TimTini/snaplock-storage-box/exports/default/preview.png

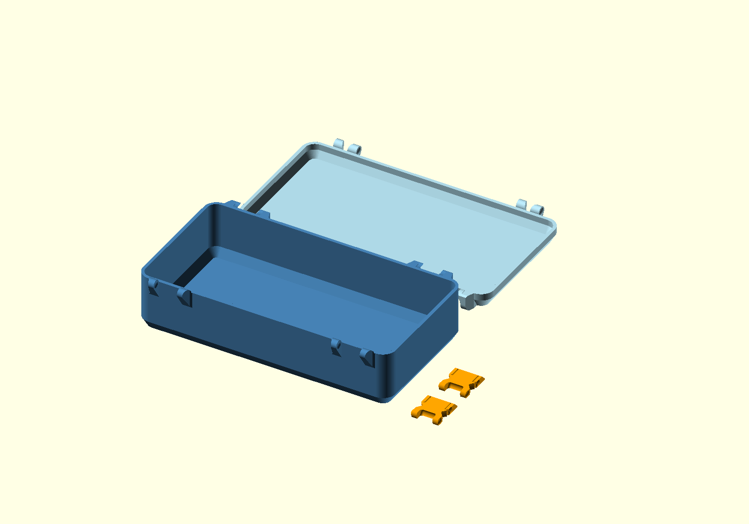
exports/default/preview.png
