TimTini/snaplock-storage-box/exports/default/sections.png

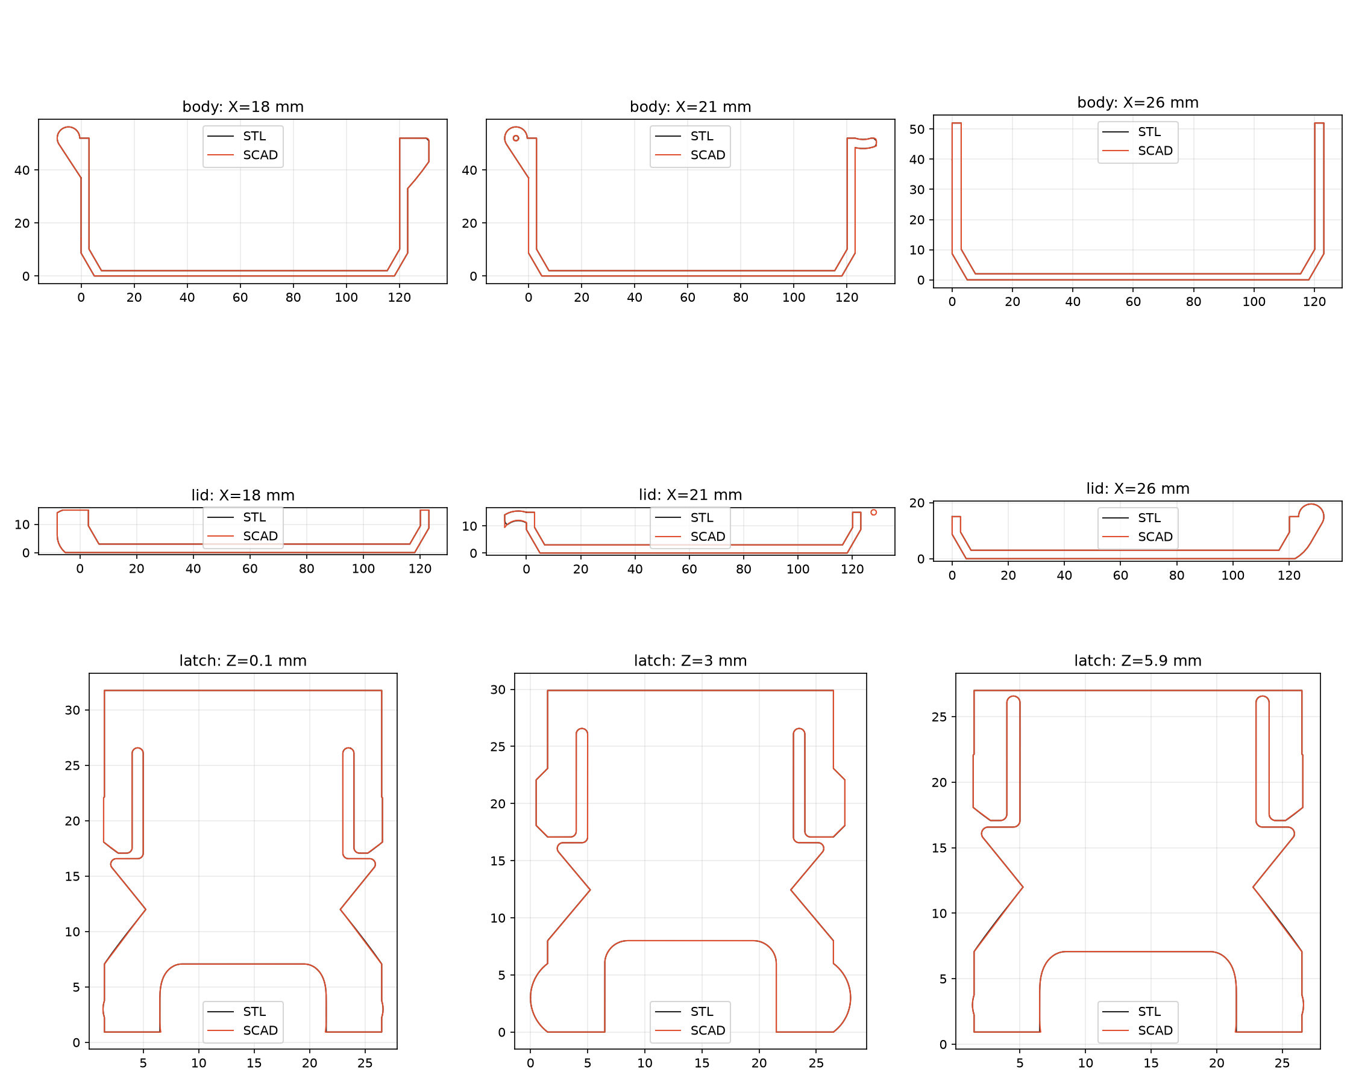
exports/default/sections.png
