TimTini/snaplock-storage-box/samples/fusion-minimum/native-preview.png

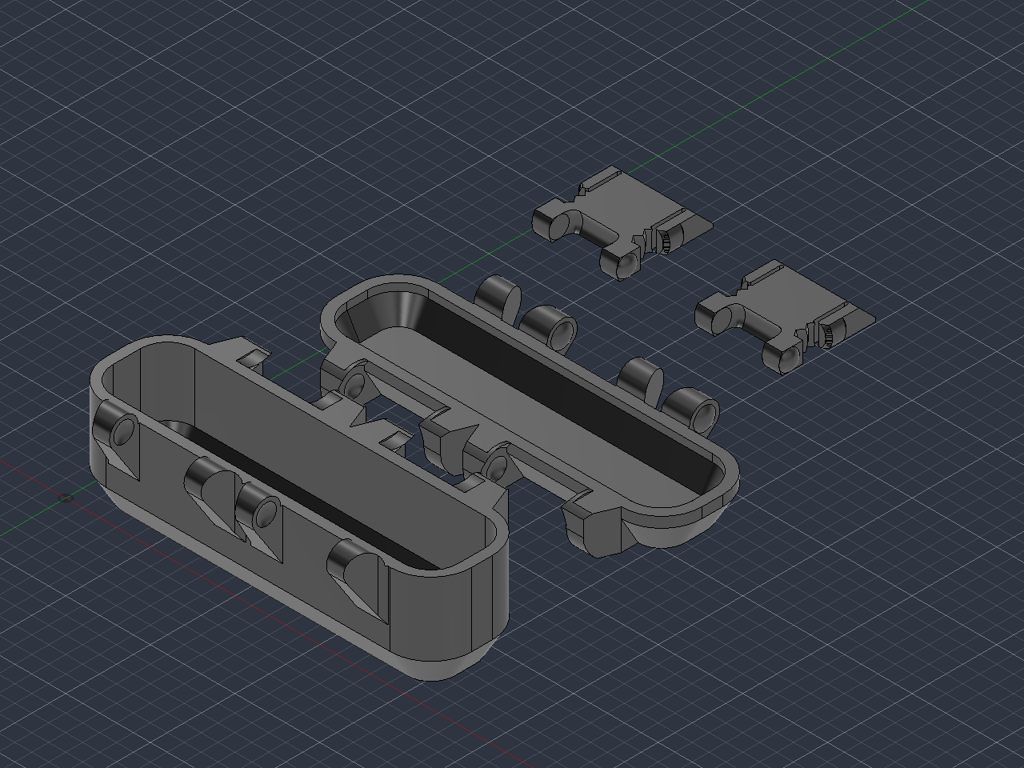
samples/fusion-minimum/native-preview.png
