TimTini/snaplock-storage-box/docs/validation/scad-parametric-assembly.csv

name | length | width | body_height | lid_height | status | max_latch_body_mm3 | max_latch_lid_mm3 | body_lid_mm3 | rear_contact_mm3 | other_contact_mm3 | within_print_envelope
grid-107.9-30.1-30.2 | 107.9 | 30.1 | 30.2 | 15 | closed_clear | 2.873825072052514e-15 | 0.0 | 9.01508005564351e-14 | 0.0 | 9.01508005564351e-14 | True
grid-107.9-30.1-50 | 107.9 | 30.1 | 50 | 15 | closed_clear | 1.1315088418159562e-13 | 8.298483428204051e-15 | 2.1815974965860418e-13 | 0.0 | 2.1815974965860418e-13 | True
grid-107.9-30.1-100 | 107.9 | 30.1 | 100 | 15 | closed_clear | 0.0 | 1.0161142760534148e-14 | 4.170900938211702e-13 | 0.0 | 4.170900938211702e-13 | True
grid-107.9-60-30.2 | 107.9 | 60 | 30.2 | 15 | closed_clear | 0.0 | 7.328686268959217e-14 | 2.8765719838361296e-13 | 0.0 | 2.8765719838361296e-13 | True
grid-107.9-60-50 | 107.9 | 60 | 50 | 15 | closed_clear | 4.4653139427535775e-13 | 6.915301664633944e-14 | 0.0 | 0.0 | 0.0 | True
grid-107.9-60-100 | 107.9 | 60 | 100 | 15 | closed_clear | 0.0 | 5.3927348697691e-14 | 0.0 | 0.0 | 0.0 | True
grid-107.9-120-30.2 | 107.9 | 120 | 30.2 | 15 | closed_clear | 0.0 | 1.4657372537918434e-13 | 0.0 | 0.0 | 0.0 | True
grid-107.9-120-50 | 107.9 | 120 | 50 | 15 | closed_clear | 7.615939257989345e-14 | 1.3830603329267888e-13 | 0.0 | 0.0 | 0.0 | True
grid-107.9-120-100 | 107.9 | 120 | 100 | 15 | closed_clear | 1.6758593967046111e-13 | 1.07854697395382e-13 | 0.0 | 0.0 | 0.0 | True
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
below-length | 107.8 | 60 | 50 | 15 | rejected_source_bounds | 0 | 0
below-width | 150 | 30 | 50 | 15 | rejected_source_bounds | 0 | 0
below-body-height | 150 | 60 | 30.1 | 15 | rejected_source_bounds | 0 | 0
below-lid-height | 150 | 60 | 50 | 11.6 | rejected_source_bounds | 0 | 0
