TimTini/snaplock-storage-box/exports/default/body.stl

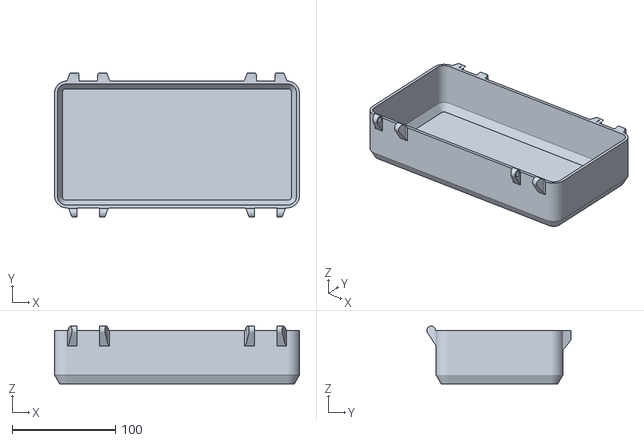
[picture p13: CAD file, 2026-10-13]
exports/default/body.stl
237.9 x 140.1 x 56.2
