TimTini/snaplock-storage-box/samples/fusion-minimum/lid.stl

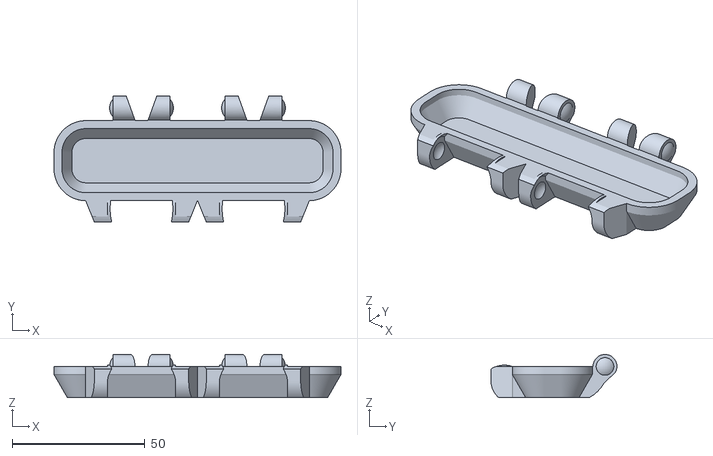
[picture p14: CAD file, 2026-10-14]
samples/fusion-minimum/lid.stl
107.9 x 47.3 x 16.2
