TimTini/snaplock-storage-box/exports/default/layout.stl

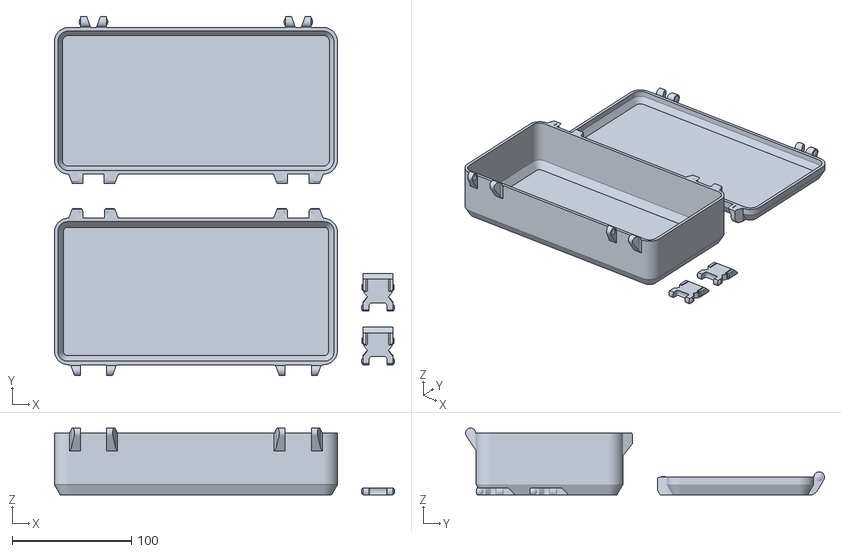
[picture p15: CAD file, 2026-10-13]
exports/default/layout.stl
285.8 x 301.5 x 56.2
