TimTini/snaplock-storage-box/samples/fusion-minimum/latch-2.stl

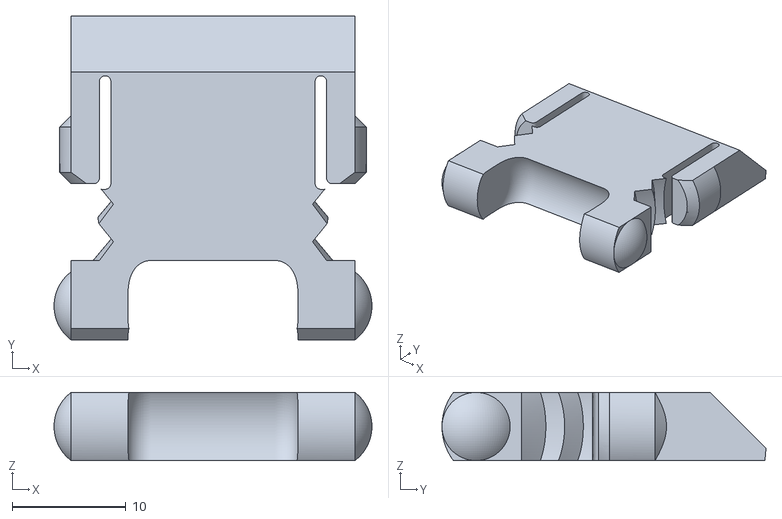
[picture p16: CAD file, 2026-10-14]
samples/fusion-minimum/latch-2.stl
28.0 x 28.5 x 6.00
