TimTini/snaplock-storage-box/exports/default/latch.stl

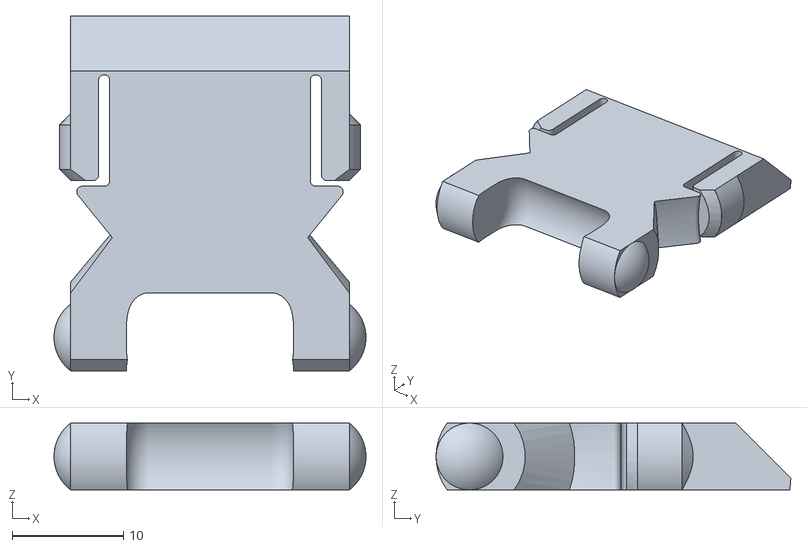
[picture p17: CAD file, 2026-10-13]
exports/default/latch.stl
28.0 x 31.8 x 6.00
