TimTini/snaplock-storage-box/samples/fusion-minimum/body.stl

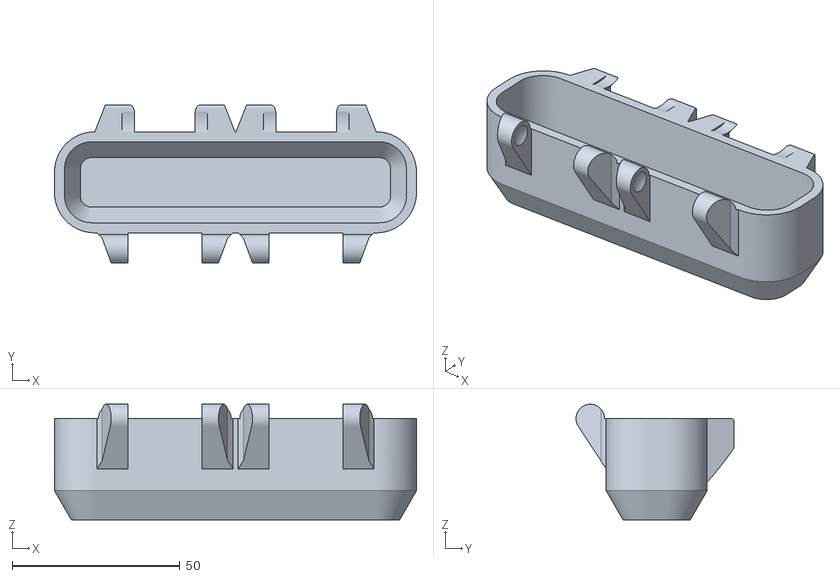
[picture p18: CAD file, 2026-10-14]
samples/fusion-minimum/body.stl
107.9 x 47.1 x 34.4
