TimTini/snaplock-storage-box/exports/default/lid.stl

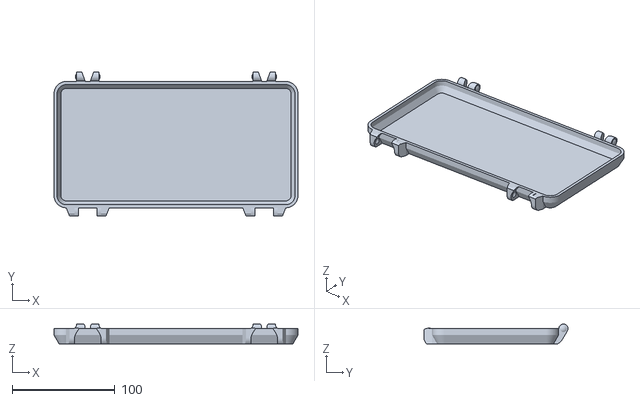
[picture p19: CAD file, 2026-10-13]
exports/default/lid.stl
237.9 x 140.4 x 19.5
