TimTini/snaplock-storage-box/samples/fusion-minimum/layout.stl

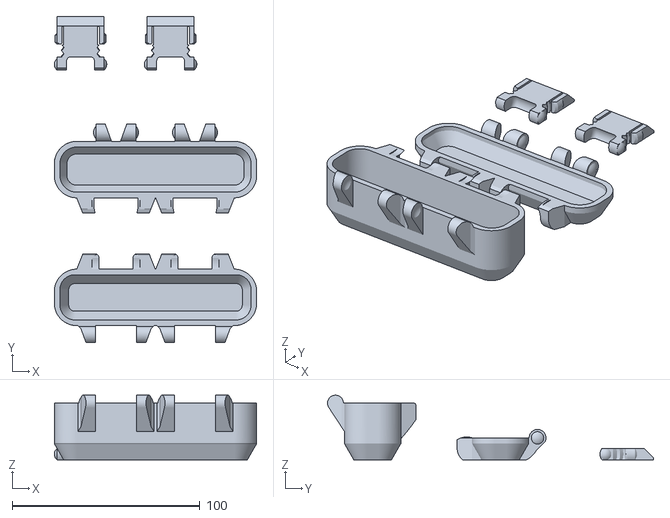
[picture p20: CAD file, 2026-10-14]
samples/fusion-minimum/layout.stl
107.9 x 173.7 x 34.4
