TimTini/snaplock-storage-box/samples/reinforced-240x220-enhanced/layout.stl

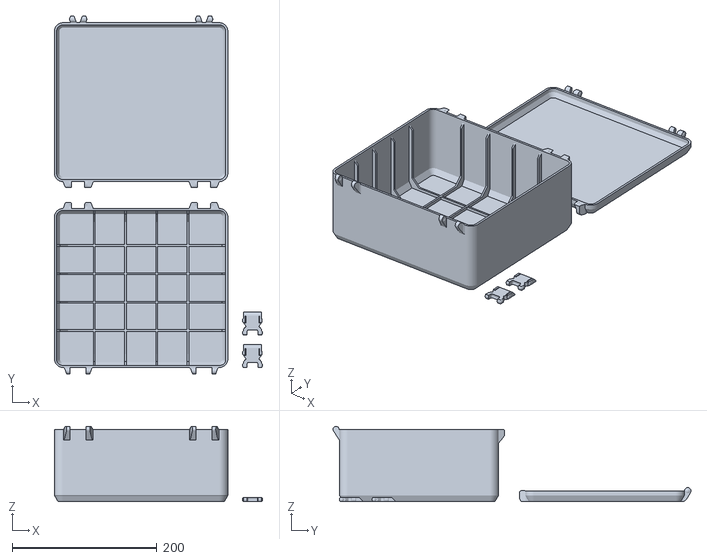
[picture p21: CAD file, 2026-10-13, an earlier design]
samples/reinforced-240x220-enhanced/layout.stl
288.0 x 495.2 x 104.2
