TimTini/snaplock-storage-box/samples/reinforced-240x220/lid.stl

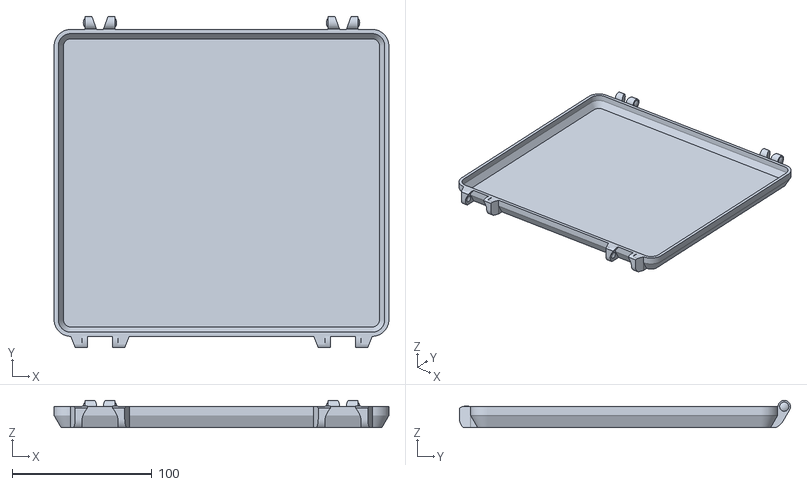
[picture p22: CAD file, 2026-10-13, an earlier design]
samples/reinforced-240x220/lid.stl
240.0 x 237.2 x 19.5
