TimTini/snaplock-storage-box/samples/minimum-lid15/lid.stl

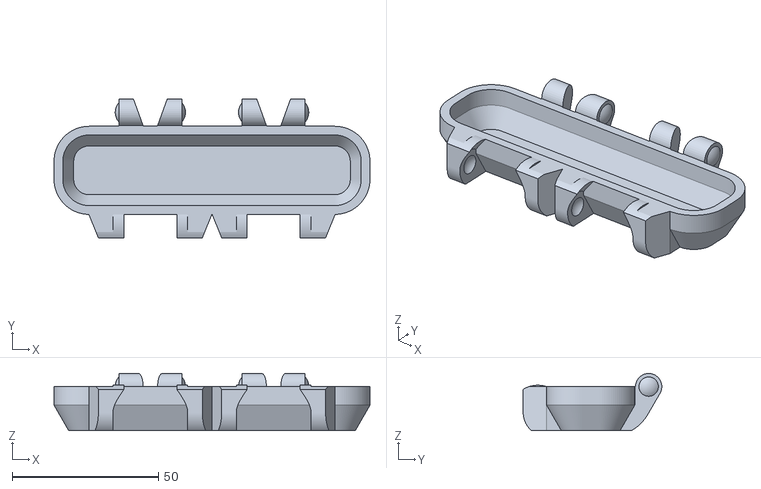
[picture p23: CAD file, 2026-10-13, an earlier design]
samples/minimum-lid15/lid.stl
107.9 x 47.3 x 19.5
