TimTini/snaplock-storage-box/samples/reinforced-240x220-enhanced/body.stl

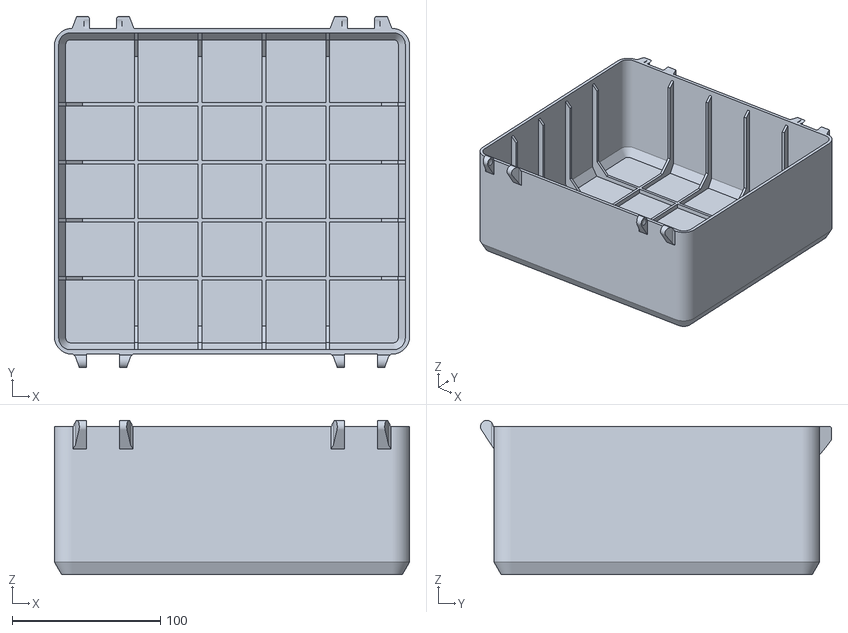
[picture p24: CAD file, 2026-10-13, an earlier design]
samples/reinforced-240x220-enhanced/body.stl
240.0 x 237.0 x 104.2
