TimTini/snaplock-storage-box/(list of files, cad)

Other CAD files:
samples/fusion-minimum/latch.stl
samples/minimum/latch.stl
samples/minimum/body.stl
samples/minimum/layout.stl
samples/minimum/lid.stl
samples/reinforced-240x220/body.stl
samples/reinforced-240x220/layout.stl
