TimTini/snaplock-storage-box/docs/validation/latch-size-matrix.csv

name | length | width | body_height | lid_height | status | max_latch_body_mm3 | max_latch_lid_mm3 | body_lid_mm3 | rear_contact_mm3 | other_contact_mm3
grid-107.9-30.1-30.2 | 107.9 | 30.1 | 30.2 | 15 | latch_clear | 0.00017263466264275383 | 2.2811613709095013e-16 | 6.2747627825592005 | 5.883868235745944 | 0.3908945468132563
grid-107.9-30.1-50 | 107.9 | 30.1 | 50 | 15 | latch_clear | 0.00017263465768553577 | 3.7669520280836366e-15 | 6.274093573222181 | 5.883877919299352 | 0.3902156539228292
grid-107.9-30.1-100 | 107.9 | 30.1 | 100 | 15 | latch_clear | 0.00017263465819112683 | 3.272078788474353e-14 | 6.274047329901294 | 5.8838316759782625 | 0.3902156539230317
grid-107.9-60-30.2 | 107.9 | 60 | 30.2 | 15 | latch_clear | 0.0 | 2.813721478034381e-15 | 6.274898882045667 | 5.883867463844314 | 0.39103141820135345
grid-107.9-60-50 | 107.9 | 60 | 50 | 15 | latch_clear | 8.511398442031823e-14 | 1.9761969838327786e-14 | 6.2740928013306645 | 5.883877147408514 | 0.39021565392215063
grid-107.9-60-100 | 107.9 | 60 | 100 | 15 | latch_clear | 0.0 | 6.364700433358905e-14 | 6.274046558009196 | 5.883830904087424 | 0.39021565392177227
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
