TimTini/snaplock-storage-box/docs/validation/scad-parametric-summary.png

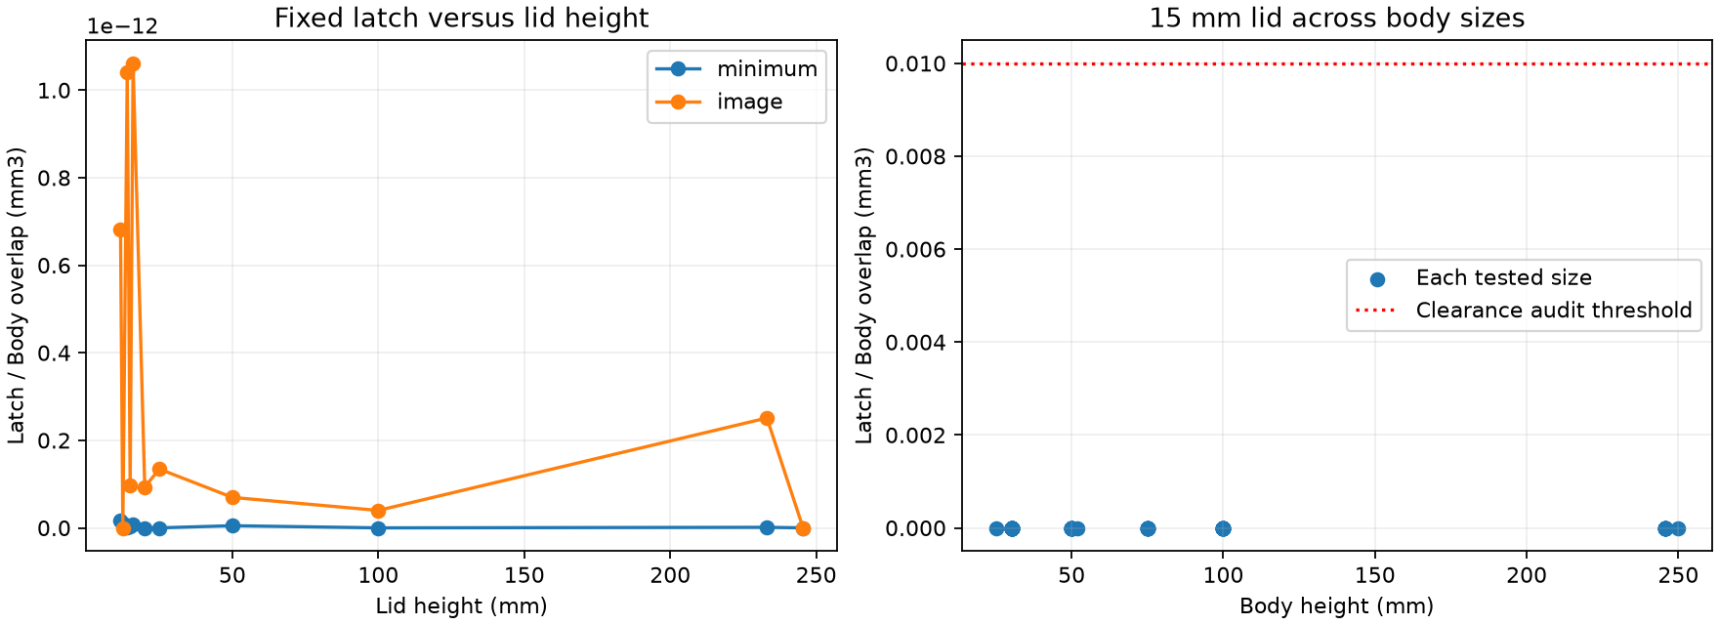
docs/validation/scad-parametric-summary.png
