TimTini/snaplock-storage-box/(commit log)

2026-10-12 Publish sanitized Snaplock SCAD and Fusion project
    [body.stl, latch.stl, layout.stl, lid.stl, snaplock-storage-box.scad]
2026-10-13 docs: add reusable STL to parametric SCAD workflow
2026-10-13 fix: derive latch offsets and extrusion from actual normals
2026-10-13 refactor: construct SCAD catch from circle and ellipse primitives
    [latch.stl, layout.stl, snaplock-storage-box.scad]
2026-10-13 refactor: split spring relief into extrusion and eight-section loft
    [latch.stl, layout.stl, snaplock-storage-box.scad]
2026-10-13 Add parallel Sweep slot probe and prioritize analytic features
2026-10-13 Add minimum-size print test with unchanged mechanism
    [body.stl, latch.stl, layout.stl, lid.stl]
2026-10-13 Prioritize shared dimensions and body height in Customizer
    [snaplock-storage-box.scad]
2026-10-13 Add three independent internal reinforcement controls and printable SCAD sample
    [body.stl, latch.stl, lid.stl, snaplock-storage-box.scad]
2026-10-13 Raise internal wall ribs and enlarge floor gussets with lid clearance checks
    [body.stl, latch.stl, lid.stl, snaplock-storage-box.scad]
2026-10-13 test(cad): reproduce minimum latch interference and add 15mm lid control
    [lid.stl]
2026-10-13 test(cad): audit closed latch assemblies across 65 size configurations
    [latch-size-matrix.csv]
2026-10-13 docs(cad): require full parameter validation from minimum to 250mm boundary
2026-10-13 Fix parametric latch assembly and organize model project
    [body.stl, latch.stl, layout.stl, lid.stl, scad-parametric-assembly.csv, snaplock-storage-box.scad]
2026-10-14 Sync Fusion latch span and mating anchors with current SCAD
2026-10-14 Verify Fusion natively and fix lid STL seams and excessive tessellation
2026-10-14 Make STL OpenSCAD Fusion learning guides portable and project independent
2026-10-14 Recheck CAD learning guides against self-learning evidence gates
2026-10-14 Fix Fusion relief datum recompute and export audited minimum print kit
    [body.stl, latch-2.stl, latch.stl, layout.stl, lid.stl]
2026-10-15 docs: relocate shared CAD guides outside model projects
2026-10-26 Standardize project folders and structure documentation
    [body.stl, latch.stl, layout.stl, lid.stl]
